gcronin/Countdown-Timer/DSCF0002.JPG

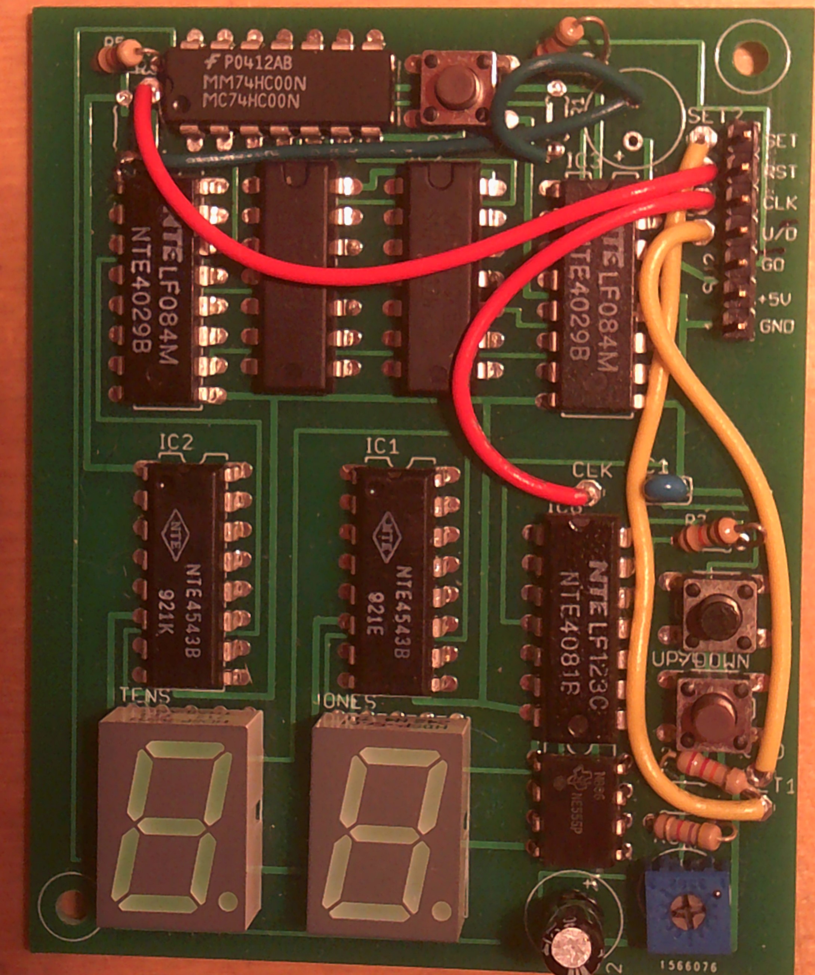
DSCF0002.JPG
