gcronin/Countdown-Timer/reset_logic.png

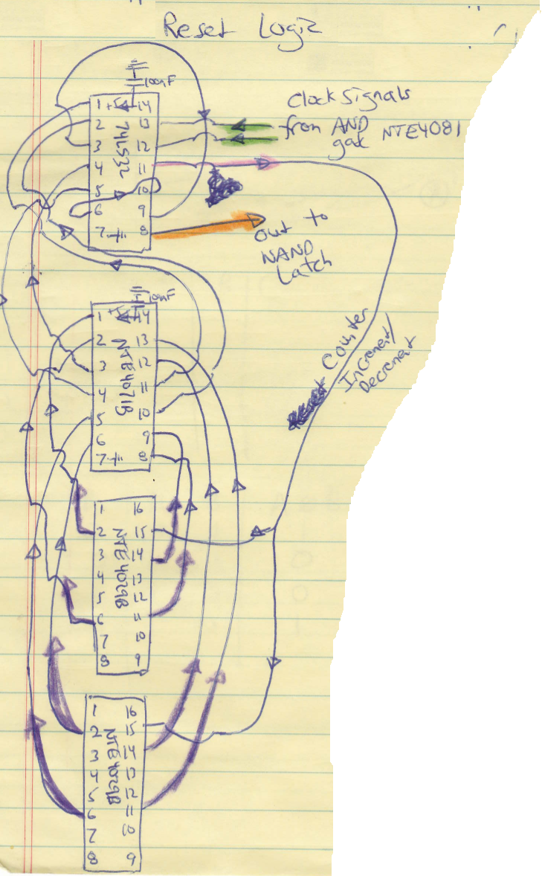
reset_logic.png
