gcronin/Countdown-Timer/click-counter.png

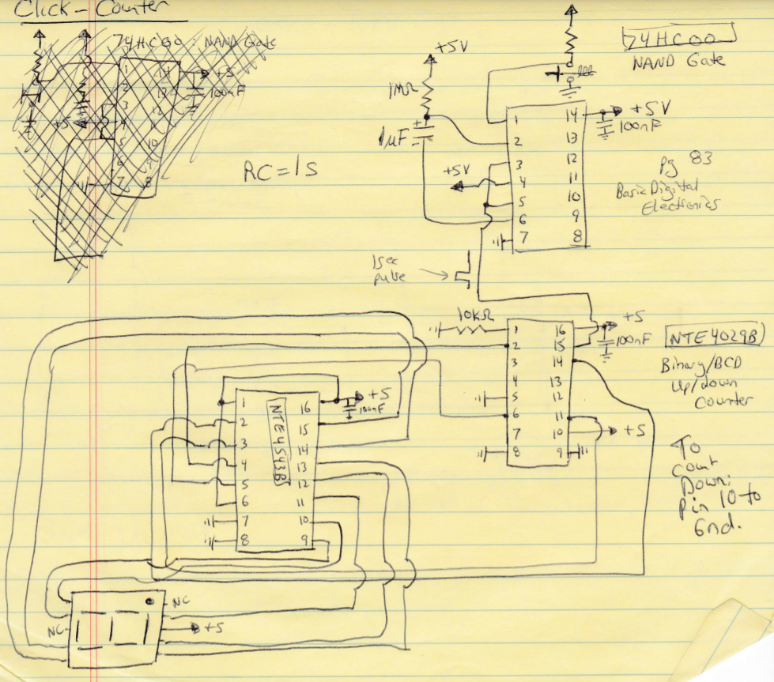
click-counter.png
