gcronin/Countdown-Timer/functional.png

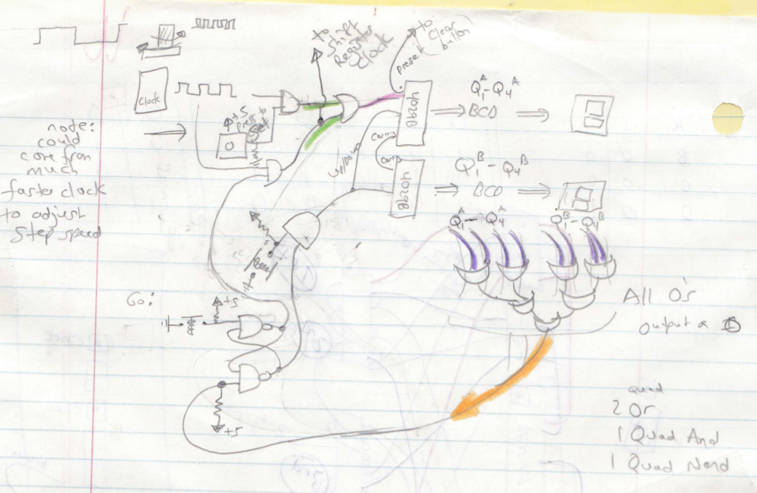
functional.png
