gcronin/Countdown-Timer/countdown_timer.brd

## EAGLE design countdown_timer.brd (2022-04-04)

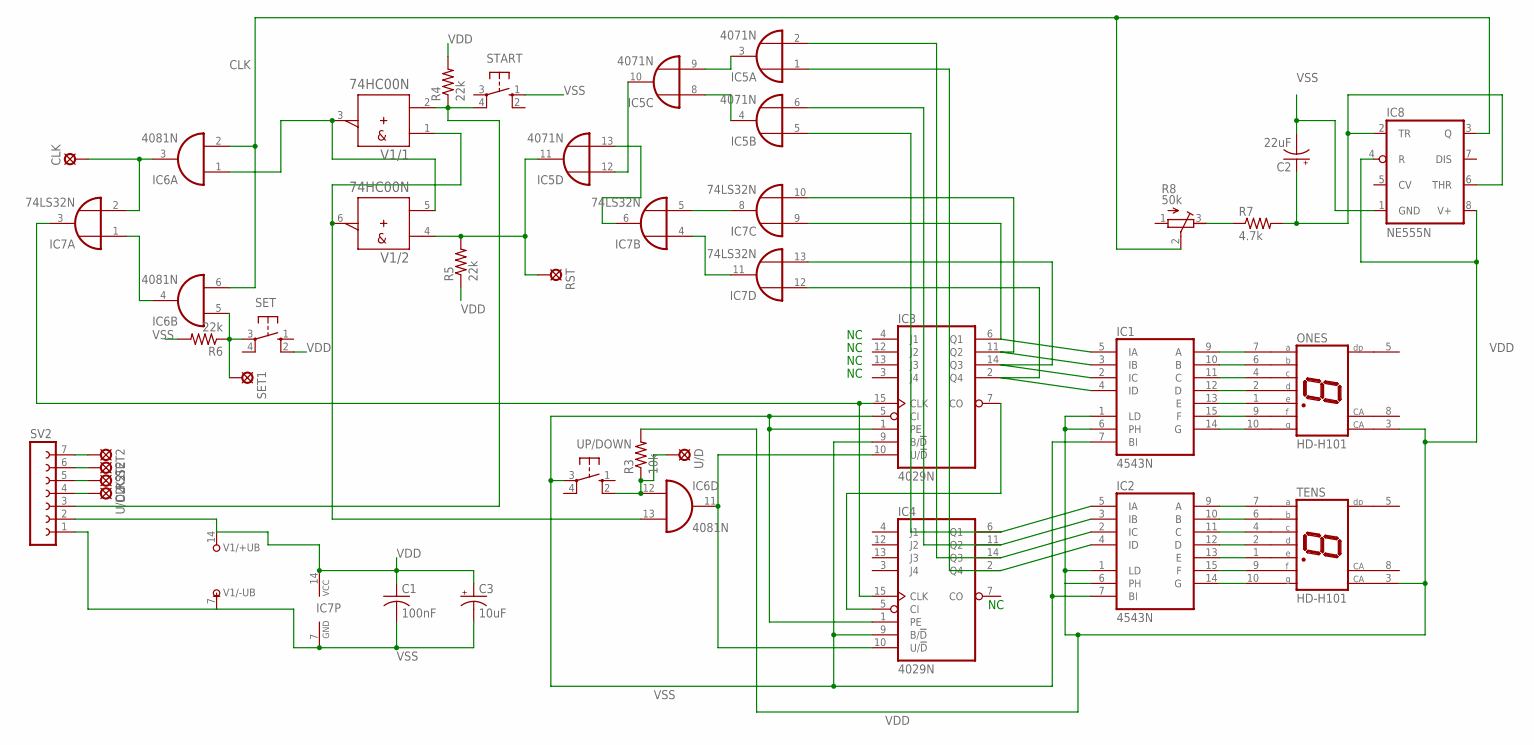
[picture p5: schematic countdown_timer.sch]

Parts:
C1: 100nF; C025-024X044
C2: 22uF; E3,5-8
C3: 10uF; E3,5-8
CLK, CLK2: LSP10
IC1, IC2: 4543N; DIL16
IC3, IC4: 4029N; DIL16
IC5: 4071N; DIL14
IC6: 4081N; DIL14
IC7: 74LS32N; DIL14
IC8: NE555N; DIL08
ONES: HD-H101; HDSP-M
R3: 10k; 0204/5
R4, R5, R6: 22k; 0204/5
R7: 4.7k; 0204/5
R8: 50k; RTRIM3339P
RST, RST2: LSP10
SET: 10-XX; B3F-10XX
SET1, SET2: LSP10
START: 10-XX; B3F-10XX
SV2: FE07-1; FE07
TENS: HD-H101; HDSP-M
U/D, U/D2: LSP10
UP/DOWN: 10-XX; B3F-10XX
V1: 74HC00N; DIL14

Connections:
CLK: IC6.2 (I1), IC6.6 (I1), IC8.3 (Q), R8.2 (S)
unnamed: IC2.9 (A), TENS.7 (A)
unnamed: IC2.10 (B), TENS.6 (B)
unnamed: IC2.11 (C), TENS.4 (C)
unnamed: IC2.12 (D), TENS.2 (D)
unnamed: IC2.13 (E), TENS.1 (E)
unnamed: IC2.15 (F), TENS.9 (F)
unnamed: IC2.14 (G), TENS.10 (G)
unnamed: IC1.9 (A), ONES.7 (A)
unnamed: IC1.10 (B), ONES.6 (B)
unnamed: IC1.11 (C), ONES.4 (C)
unnamed: IC1.12 (D), ONES.2 (D)
unnamed: IC1.13 (E), ONES.1 (E)
unnamed: IC1.15 (F), ONES.9 (F)
unnamed: IC1.14 (G), ONES.10 (G)
unnamed: IC7.4 (I0), IC7.11 (O)
unnamed: IC7.5 (I1), IC7.8 (O)
unnamed: IC5.4 (O), IC5.8 (I0)
unnamed: IC1.2 (IC), IC3.14 (Q3), IC7.13 (I1)
unnamed: IC2.5 (IA), IC4.6 (Q1), IC5.5 (I0)
unnamed: IC2.3 (IB), IC4.11 (Q2), IC5.6 (I1)
unnamed: IC2.2 (IC), IC4.14 (Q3), IC5.2 (I1)
unnamed: IC2.4 (ID), IC4.2 (Q4), IC5.1 (I0)
unnamed: IC3.7 (CO), IC4.5 (CI)
unnamed: IC3.10 (U/!D), IC4.10 (U/!D), IC6.11 (O)
unnamed: IC6.12 (I0), R3.1, U/D.MP, UP/DOWN.2 (S1)
unnamed: IC5.11 (O), R5.2, RST.MP, V1.4 (A)
unnamed: IC5.3 (O), IC5.9 (I1)
unnamed: IC5.10 (O), IC5.12 (I0)
unnamed: IC5.13 (I1), IC7.6 (O)
unnamed: RST2.MP, SV2.6
unnamed: CLK2.MP, SV2.5
unnamed: SV2.4, U/D2.MP
unnamed: IC6.1 (I0), V1.3 (Y), V1.5 (B)
unnamed: IC6.13 (I1), V1.1 (A), V1.6 (Y)
unnamed: R4.1, START.4 (P1), SV2.3, V1.2 (B)
unnamed: SET2.MP, SV2.7
unnamed: CLK.MP, IC6.3 (O), IC7.2 (I1)
unnamed: IC6.4 (O), IC7.1 (I0)
unnamed: IC6.5 (I0), R6.1, SET.3, SET1.MP
unnamed: IC3.15 (CLK), IC4.15 (CLK), IC7.3 (O)
unnamed: R7.1, R8.3 (E)
unnamed: C2.+, IC8.2 (TR), IC8.6 (THR), R7.2
unnamed: IC1.4 (ID), IC3.2 (Q4), IC7.12 (I0)
unnamed: IC1.3 (IB), IC3.11 (Q2), IC7.10 (I1)
unnamed: IC1.5 (IA), IC3.6 (Q1), IC7.9 (I0)
VDD: C1.1, C3.+, IC1.1 (LD), IC1.6 (PH), IC1.16 (VDD), IC2.1 (LD), IC2.6 (PH), IC2.16 (VDD), IC3.16 (VDD), IC4.16 (VDD), IC5.14 (VDD), IC6.14 (VDD), IC7.14 (VCC), IC8.4 (R), IC8.8 (V+), ONES.3 (CA), R3.2, R4.2, R5.1, SET.2 (S1), SV2.2, TENS.3 (CA), V1.14 (+UB)
VSS: C1.2, C2.-, C3.-, IC1.7 (BI), IC1.8 (VSS), IC2.7 (BI), IC2.8 (VSS), IC3.1 (PE), IC3.5 (CI), IC3.8 (VSS), IC3.9 (B/!D), IC4.1 (PE), IC4.8 (VSS), IC4.9 (B/!D), IC5.7 (VSS), IC6.7 (VSS), IC7.7 (GND), IC8.1 (GND), R6.2, START.1 (S), SV2.1, UP/DOWN.3, V1.7 (-UB)

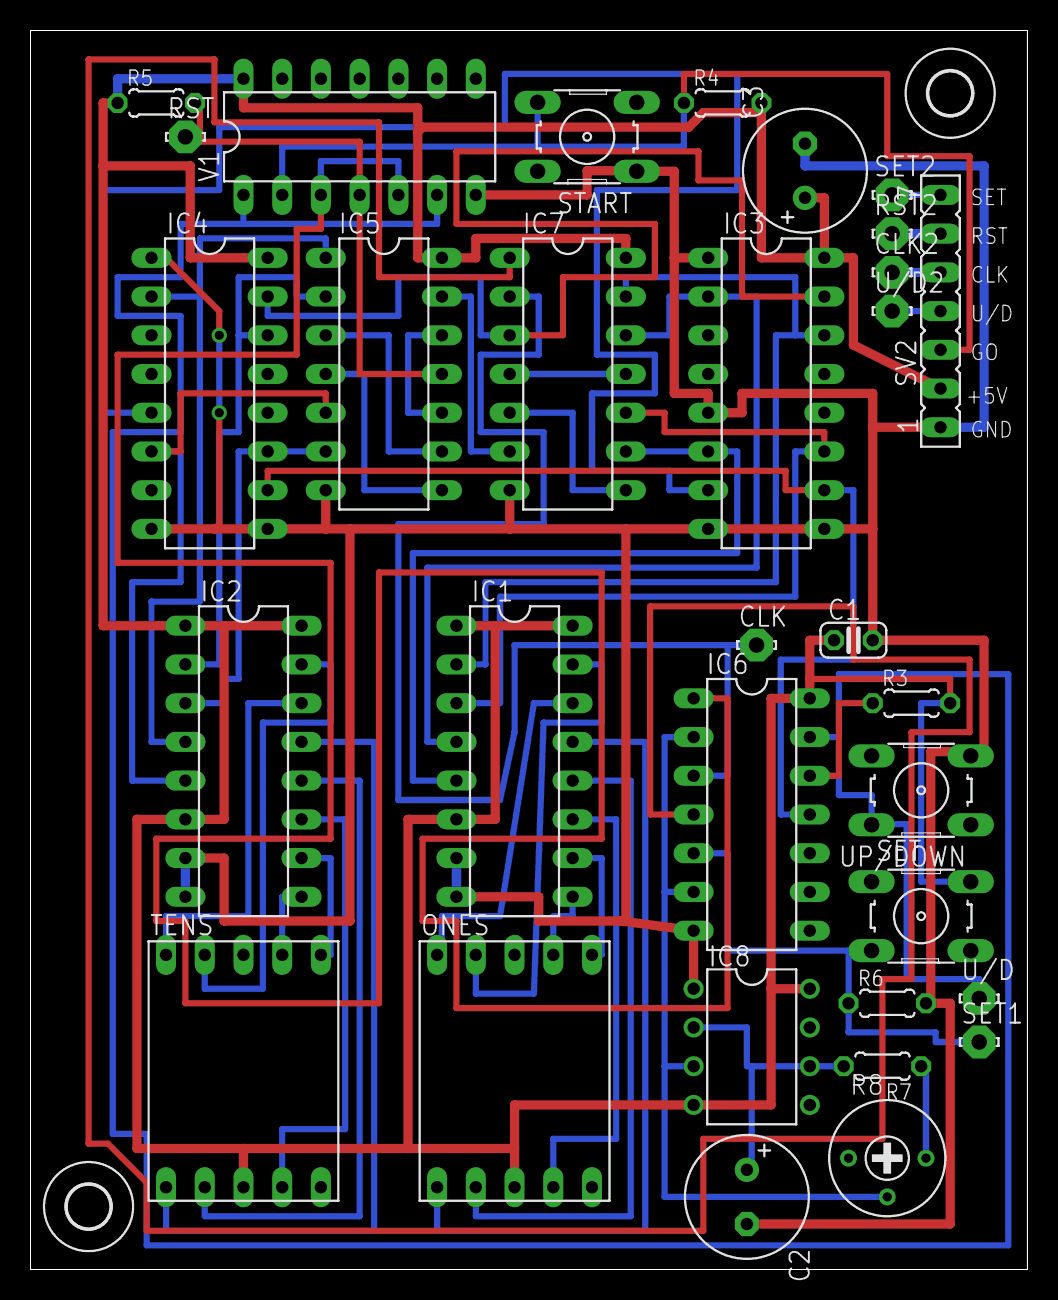
[picture p6: board countdown_timer.brd from above]

Board: 2 copper layers, 65.4 x 81.3 mm, 34 parts (0 on the bottom side), 48 nets.

Other parts of the board:
U$2, U$3: 2,8
